Savan25/Survey_Vehicle/README.md

#  Microcontroller-Based Survey Vehicle

## The files listed in "Final_Version" are the latest copy of the program code uploaded to the microcontroller.

### **Project Details**
- **Student Name:** Savan Lacmane
- **Student ID:** 160466539
- **Project Title:** Microcontroller-Based Survey Vehicle
- **Project Supervisor:** Dr Chris Phillips

### **Components and Software**
- [AT89S8253](http://ww1.microchip.com/downloads/en/devicedoc/doc3286.pdf) microcontroller from the 8051 family.
- [28BYJ-48](http://robocraft.ru/files/datasheet/28BYJ-48.pdf) stepper motors.
- [IIC 128x64 OLED display](https://www.amazon.co.uk/d/B01GC4067O).
- [HC-05](https://drive.google.com/file/d/0B4urklB65vaCYmxZZlJ1dmw2NzA/view) Bluetooth module.
- Infrared [emitters](https://www.rapidonline.com/pdf/58-0100.pdf) and [sensors](https://www.rapidonline.com/pdf/58-0320.pdf) (diodes).
- Assembly code and [MCU8051 IDE](https://sourceforge.net/projects/mcu8051ide/).
