Savan25/Survey_Vehicle/QMUL Project/Savan_Lacmane_160466539_Poster.pdf

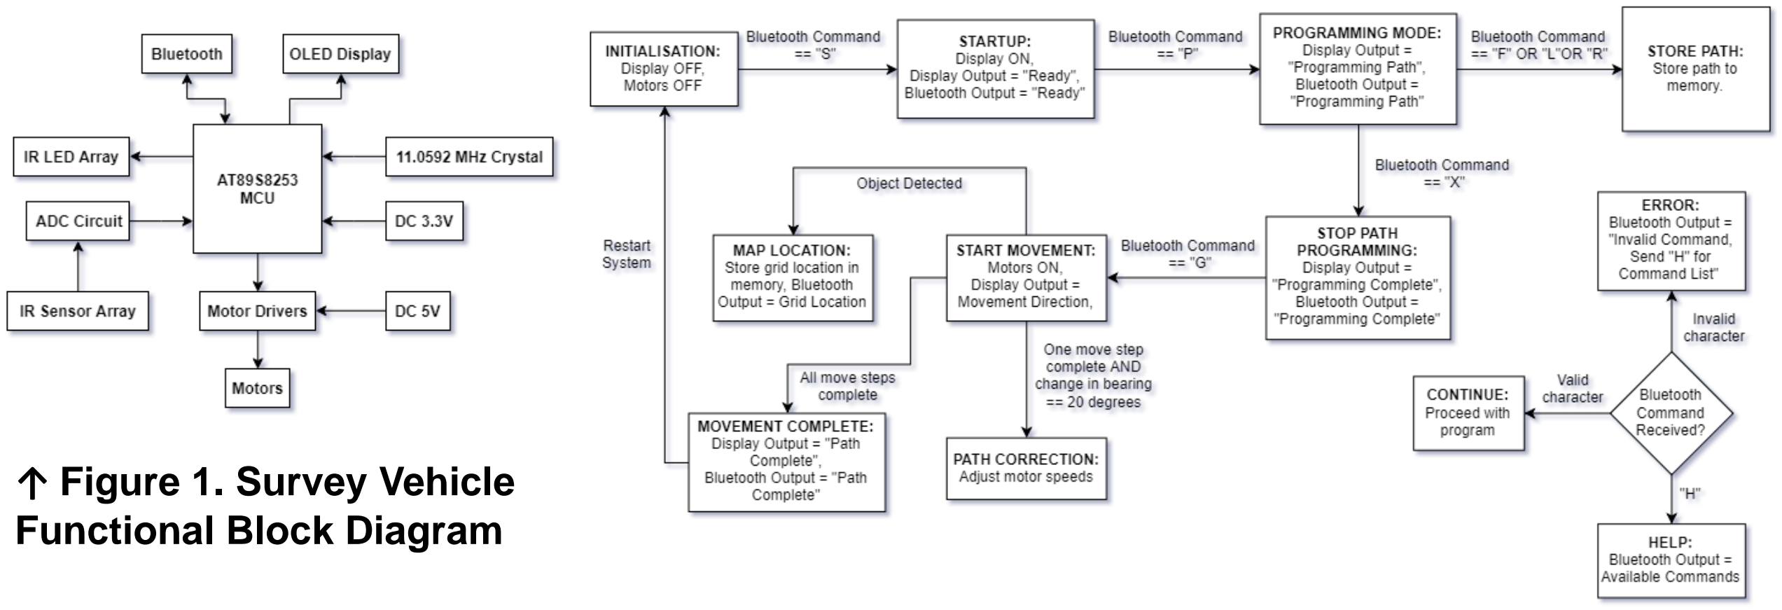
[picture p32: figure]
↑ Figure 1. Survey Vehicle Functional Block Diagram

School of Electronic Engineering and Computer Science

# Microcontroller-Based Survey Vehicle

# Savan Lacmane

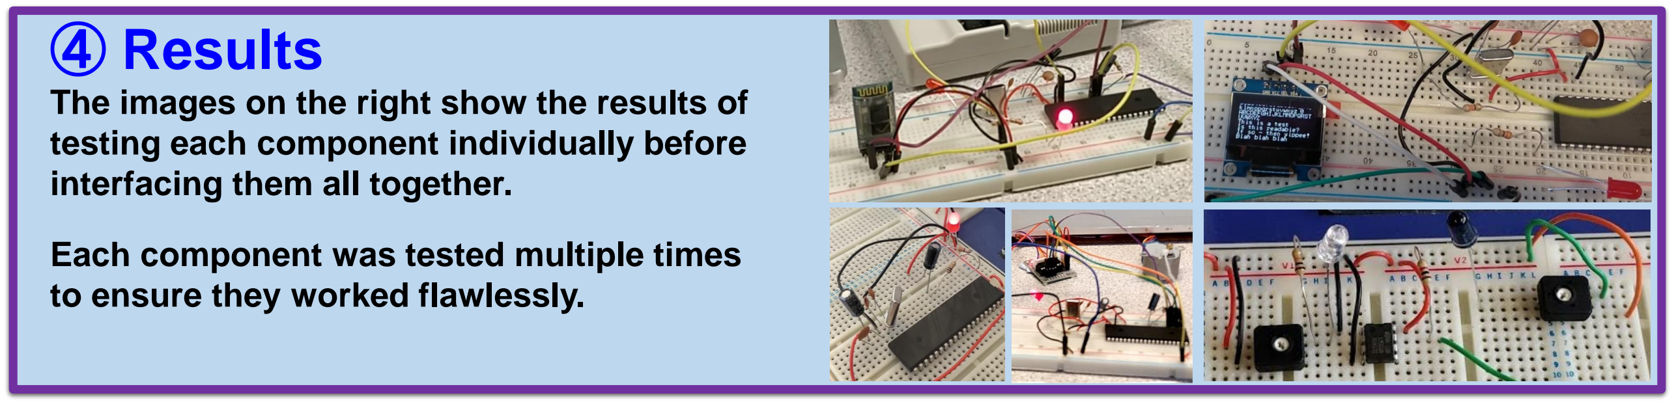
[picture p33: figure]
④ Results; interfacing them all together.; to ensure they worked flawlessly.

## ① Aim & Objectives

To design and implement a cost-effective roaming vehicle that can be used to survey an area of terrain. Object detection is the main surveillance feature, with the possibility of adding or changing sensors. The vehicle should scan the area without overlapping and map the location of features relative to the starting point.
The vehicle should be able to follow a pre-programmed path with a precision of about ±20cm with a mechanism for location awareness. It should be capable of 45, 90, and 180 degree turns. The vehicle should be able to autonomously scan an and roam an area.
Student Number: 160466539 | Supervisor: Dr Chris Phillips

## ② Design Overview

Components:
- Microcontroller: AT89S825
- Stepper Motors: 28BYJ-48
- Motor Drivers: ULN2003A
- Bluetooth: HC-05
- Display: 128x64 IIC OLED
- Sensing: Infrared
- Analogue to Digital Convertor: LM311

Software:
- MCU8051 IDE
- EasyPRO Programmer
- Dataman-Pro PG4UW Programmer
- Fritzing
- Draw.io

Programmers:
- EasyPRO 90B
- Dataman 48Pro2C

↑ Figure 2. Survey Vehicle System Behaviour Overview

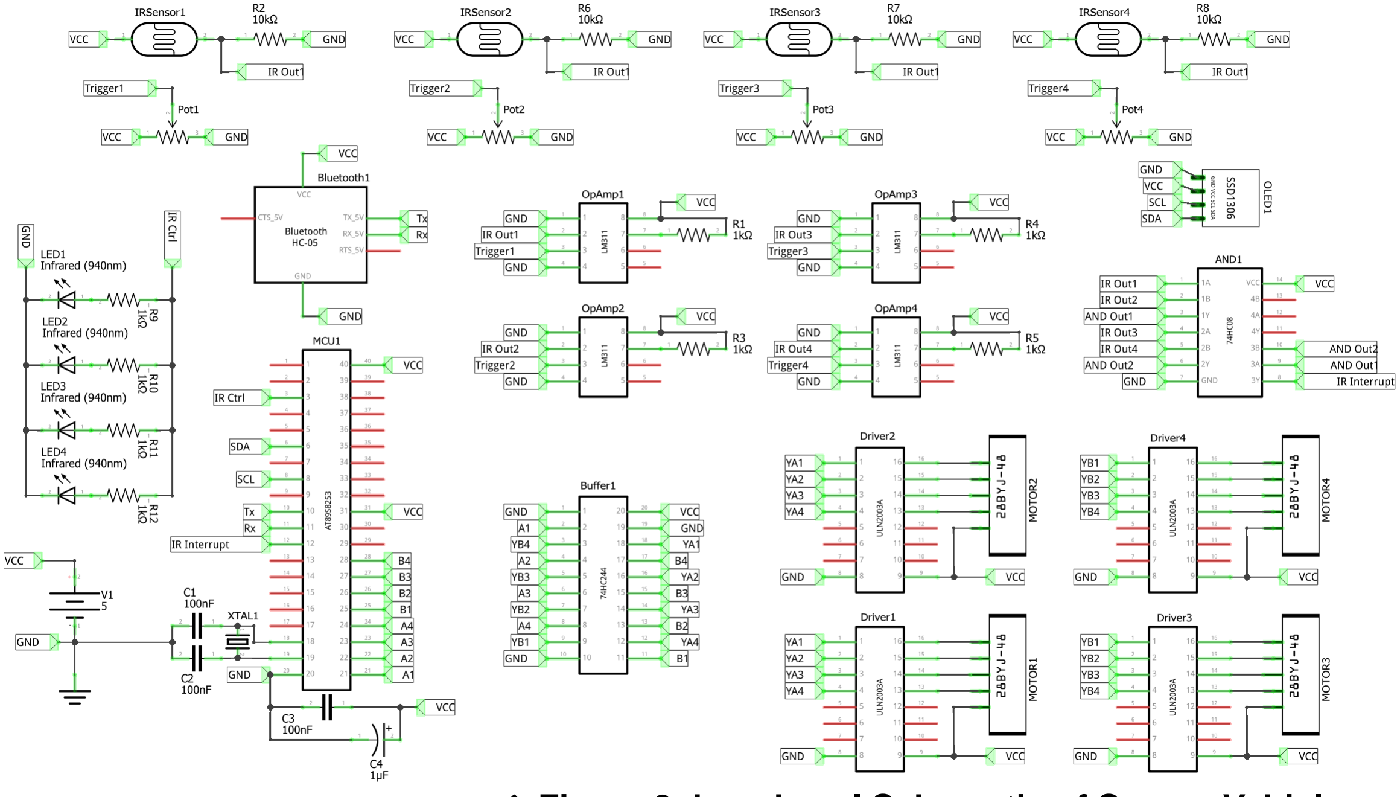
[picture p34: figure]

↑ Figure 3. Low-Level Schematic of Survey Vehicle

The images on the right show the results of testing each component individually before

Each component was tested multiple times

## ⑤ Conclusion

A small survey vehicle was designed and implemented using an 8051 microcontroller. It is capable of object detection via infrared sensing and precise movement using stepper motors, featuring Bluetooth communication.

Future improvements include (but not limited to) adding orientation awareness, increasing power efficiency, and additional sensors for surveying different features of terrain.

Acknowledgments
Dr Chris Phillips (Project Supervisor), Mr Ho Huen (Electronics Lab Manager), Mr David Wilkinson (Electronics Lab Technician), Miss Patricia Goddard (Electronics Lab Technician)

References

Microchip, 2010. AT89S8253 Datasheet. San Jose(CA): Atmel Corporation.

Mazidi, M. A., Mazidi, J. G. & McKinlay, R. D., 2005. The 8051 Microcontroller and Embedded Systems. 2nd ed. Harlow(Essex): Pearson Education Limited.

## ③ Methodology

When design the system, each component was tested individually. After each component was confirmed to be working as intended, they were tested together with other components. Following this process, all the components were tested together and ensured working.

After writing snippets of code for each component, simulations were run to ensure the code behaved appropriately, before implementing it on the hardware. The MCU8051 IDE was used to compile and simulate the code.
