Savan25/Survey_Vehicle/(list of files, cad)

Other CAD files:
5_Bluetooth_v2/BT in C/HC-05_Bluetooth/LED_Control_using_Bluetooth.OBJ
5_Bluetooth_v2/BT in C/HC-05_Bluetooth/UART_C_file.OBJ
