Savan25/Survey_Vehicle/5_Bluetooth_v2/BT in C/HC-05_Bluetooth/UART_C_file.c

/*
 * UART_C_file.c
 *
 * http://www.electronicwings.com
 */

#include"UART_H_file.h"

void UART_Init()
{
	TMOD = 0x20;
	TH1 = 0xFD;
	SCON = 0x50;
	TR1 = 1;
}

void UART_TxChar(char Data)
{
	SBUF = Data;
	while (TI==0);
	TI = 0;
}

char UART_RxChar()
{
	char dat;
	while (RI==0);
	RI = 0;
	dat = SBUF;
	return(dat);
}
	
void UART_SendString(char *str)
{
     int i;
     for(i=0;str[i]!=0;i++)
		{
         UART_TxChar(str[i]);
    }
}
